ennukim/Moodmusic/Presentation.pdf

## Moodmusic

Anthony Lam and Sally Kim

### Design Concept

A music player that automatically chooses a music to play for the user depending on the user’s mood, defined by biometrics and environment.

### Key Parts

Sensors:

- Temperature (DS18B20)
- Motion (ADXL345)
- Light (Photoresistor)
- Heart Rate

Others:

- ADC (MCP3002)
- Audio Jack (Stereo Decoder)

### Circuits - Analog Sensors

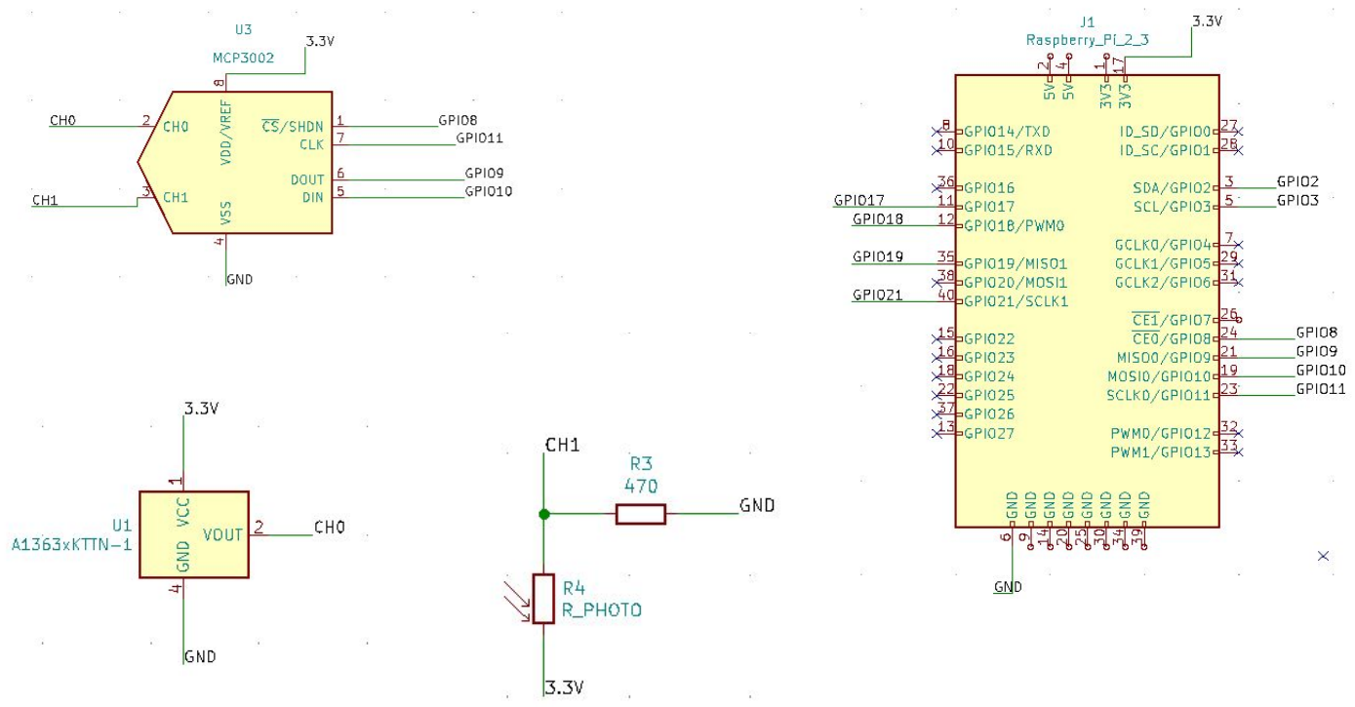
[picture p12: figure]

Ch0 - Heart rate
sensor

Ch1 - Photoresistor

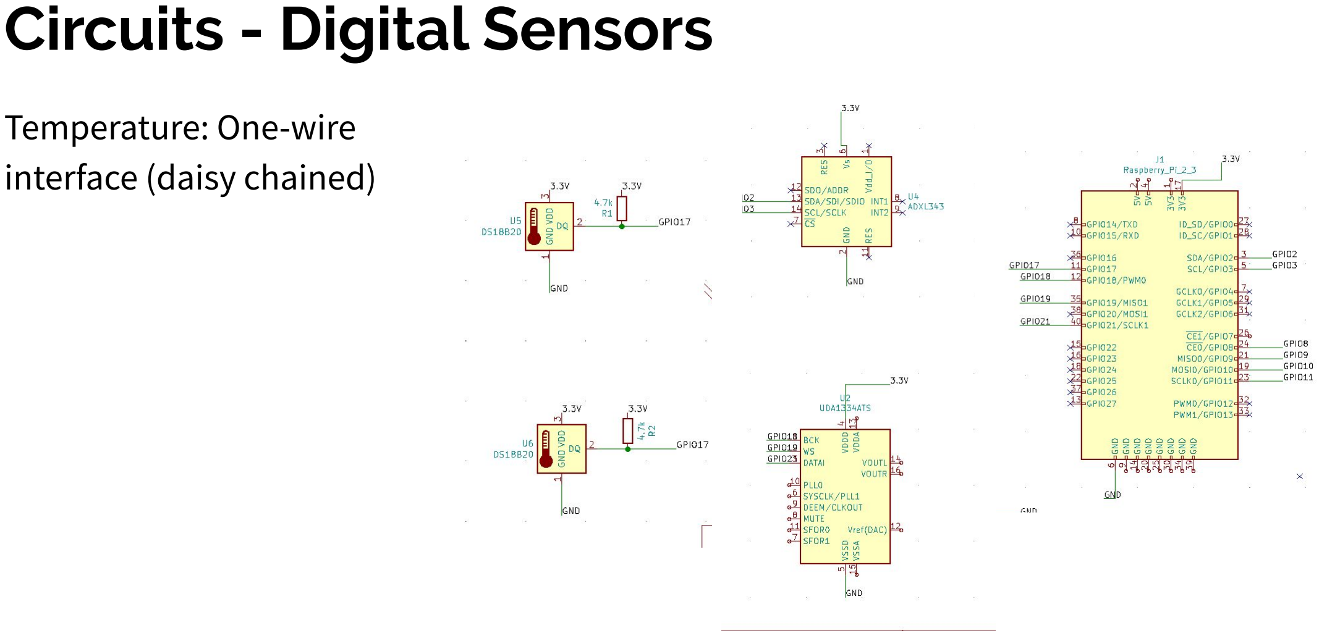
[picture p13: page 5]

### Circuits - Digital Sensors

Temperature: One-wire
interface (daisy chained)

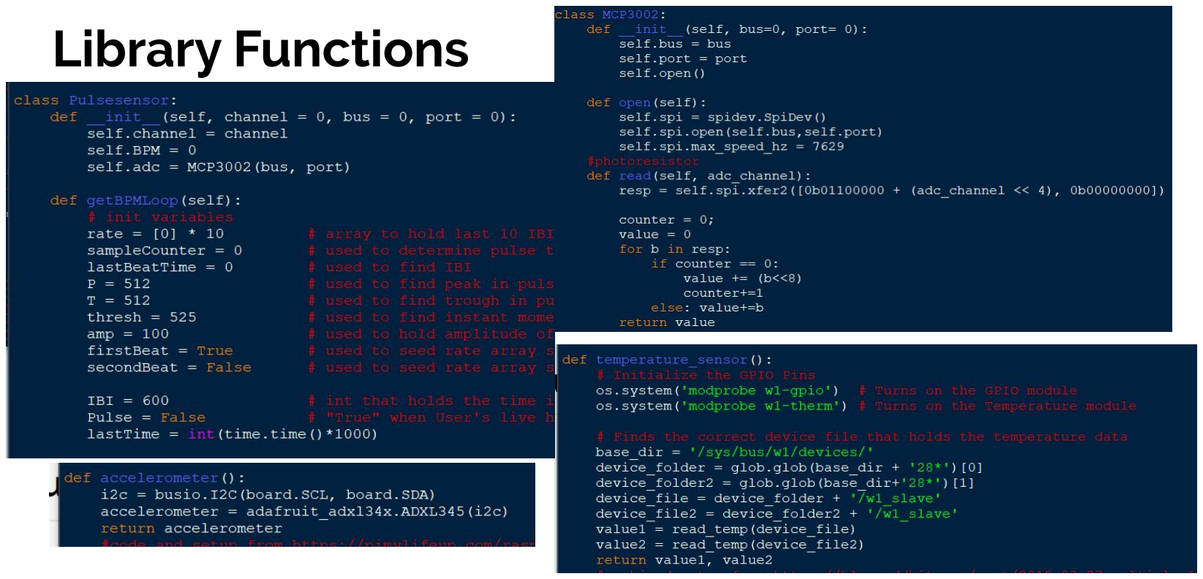
[picture p14: page 6]

### Library Functions

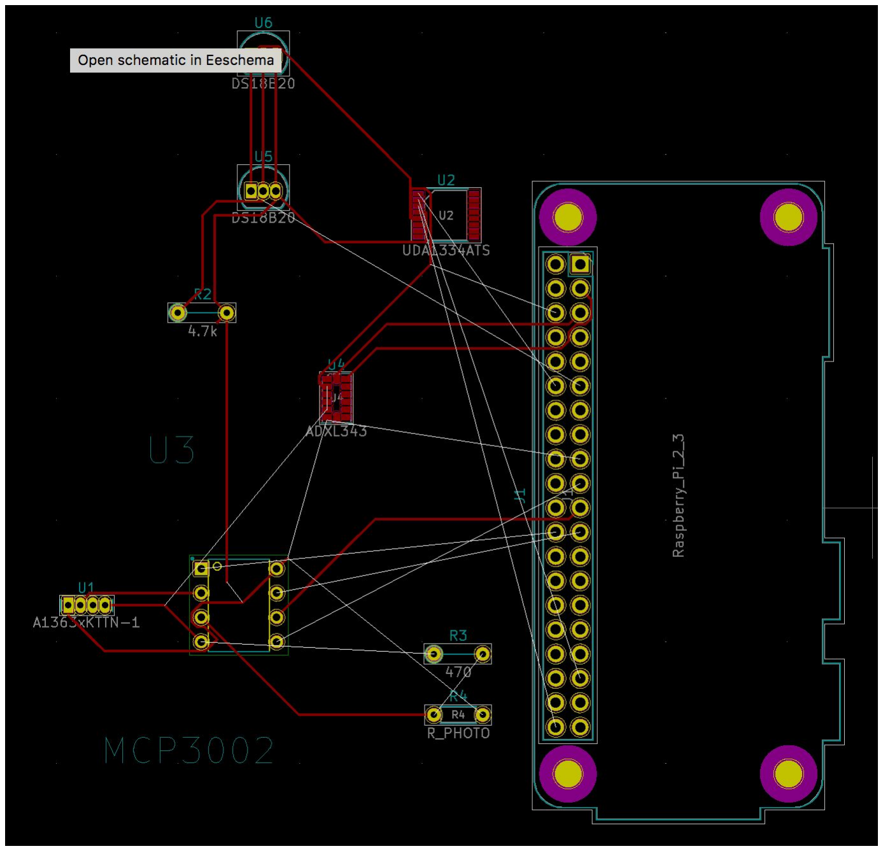
[picture p15: figure]

### PCB layout
