ennukim/Moodmusic/hardware_design/moodmusic_schematic.pdf

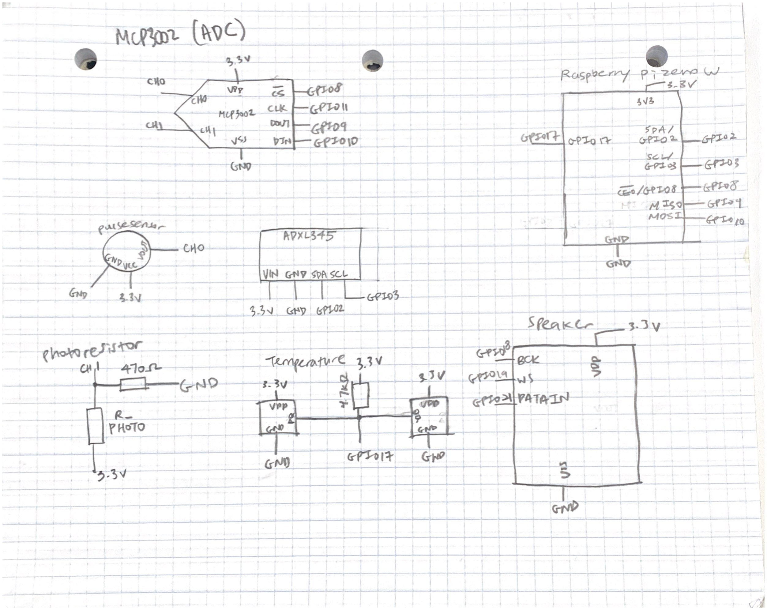
[picture p16: figure]
