ennukim/Moodmusic/mood_algorithm.png

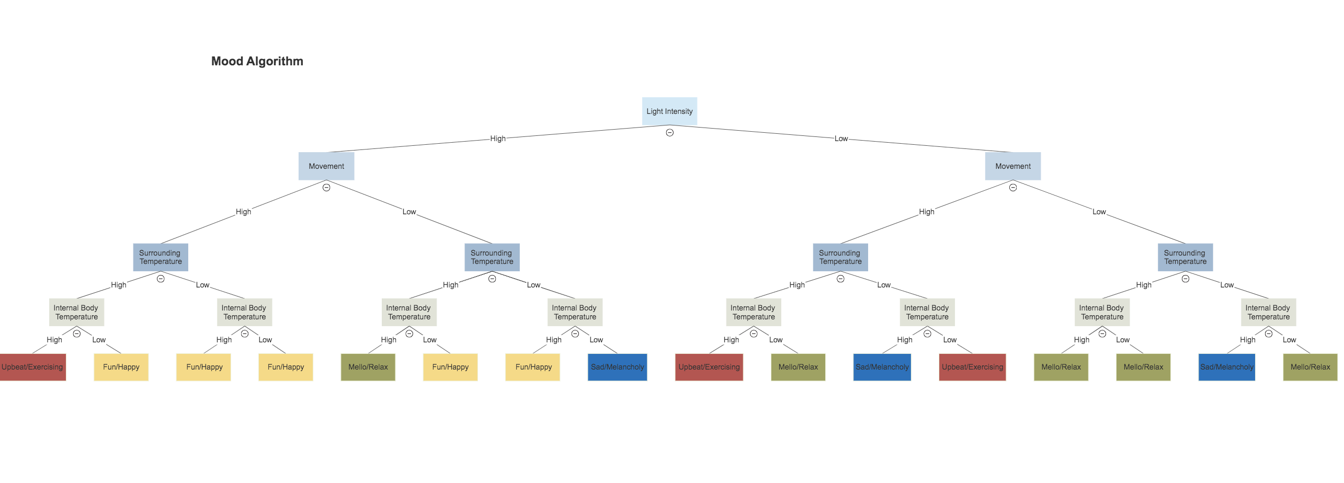
mood_algorithm.png
