ennukim/Moodmusic/UI/add_music.png

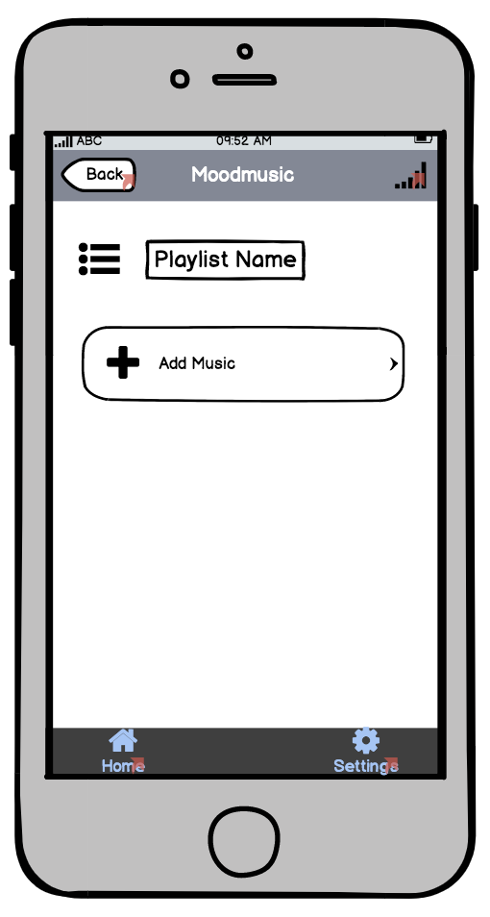
UI/add_music.png
