ennukim/Moodmusic/UI/home_screen.png

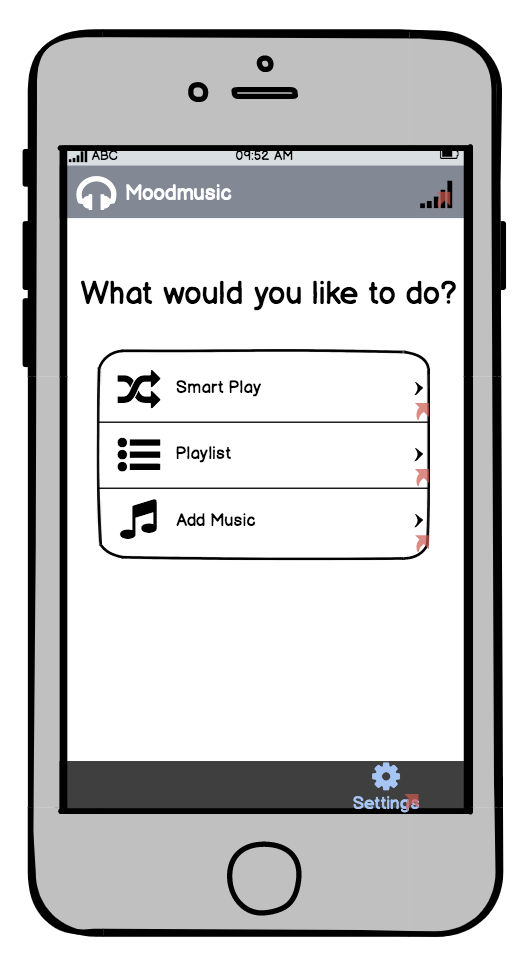
UI/home_screen.png
