ennukim/Moodmusic/UI/import_music.png

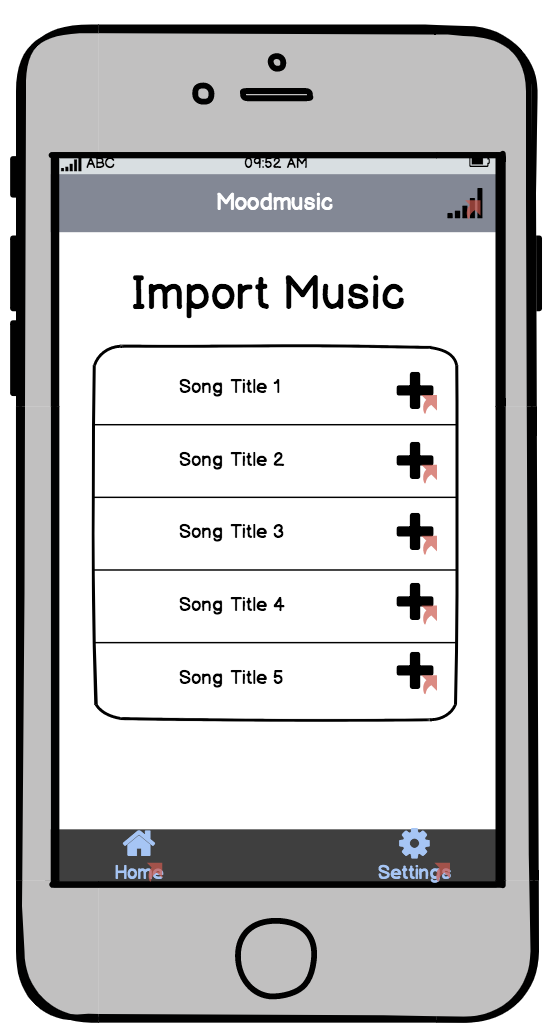
UI/import_music.png
