ennukim/Moodmusic/UI/label_mood.png

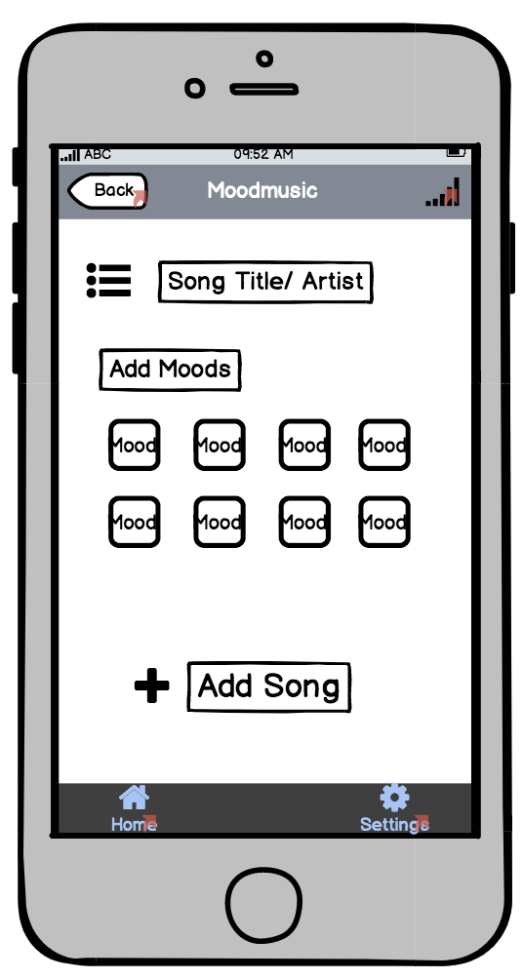
UI/label_mood.png
