ennukim/Moodmusic/UI/mood_config.png

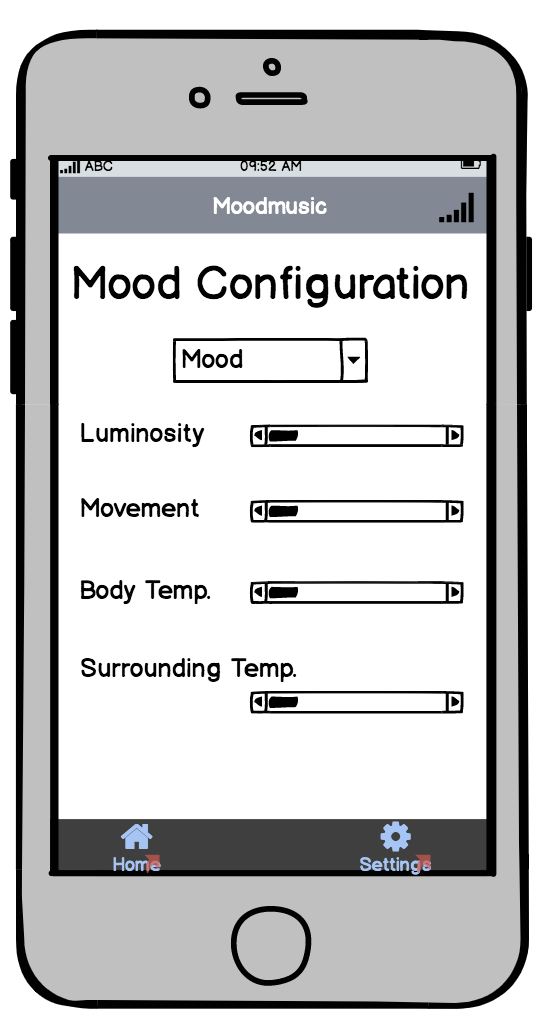
UI/mood_config.png
