ennukim/Moodmusic/UI/mood_description.png

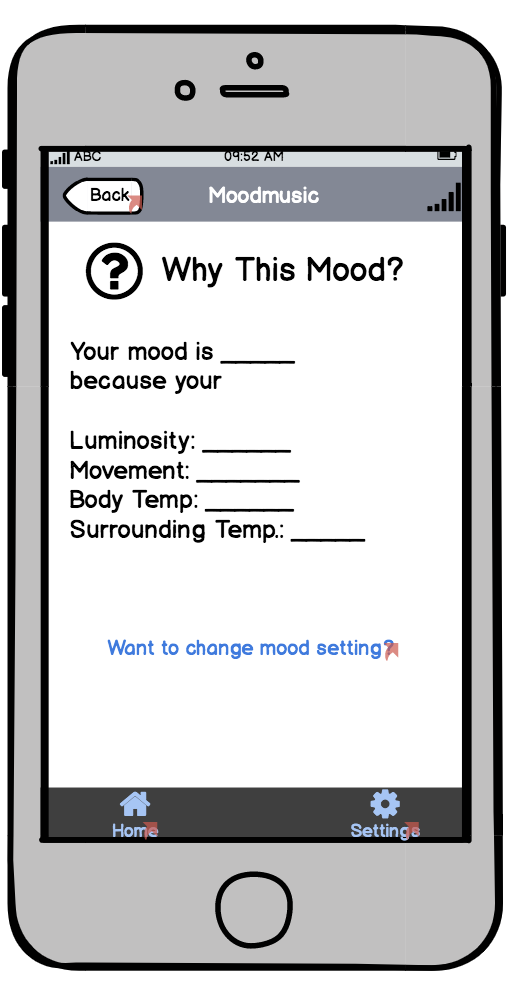
UI/mood_description.png
