ennukim/Moodmusic/UI/music_screen.png

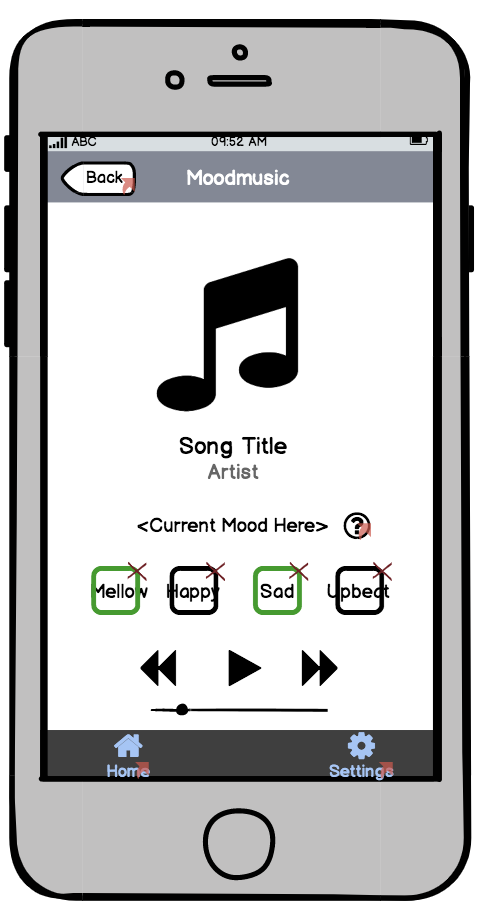
UI/music_screen.png
