ennukim/Moodmusic/UI/playlist.png

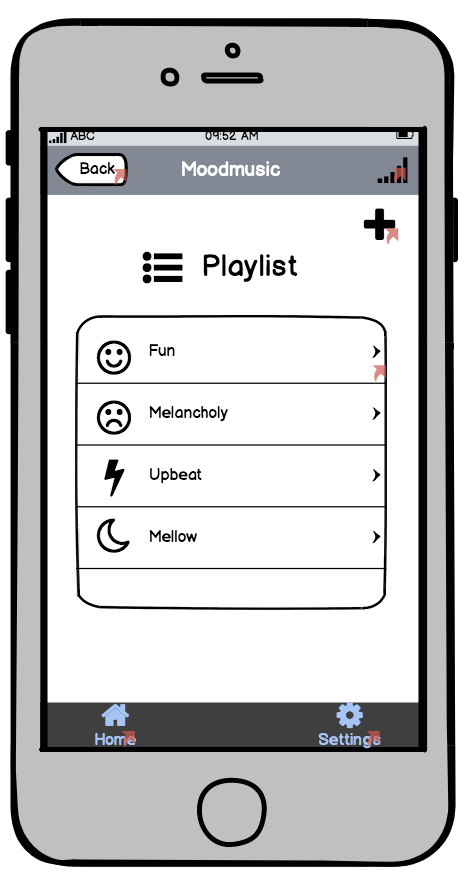
UI/playlist.png
