ennukim/Moodmusic/UI/playlist_fun.png

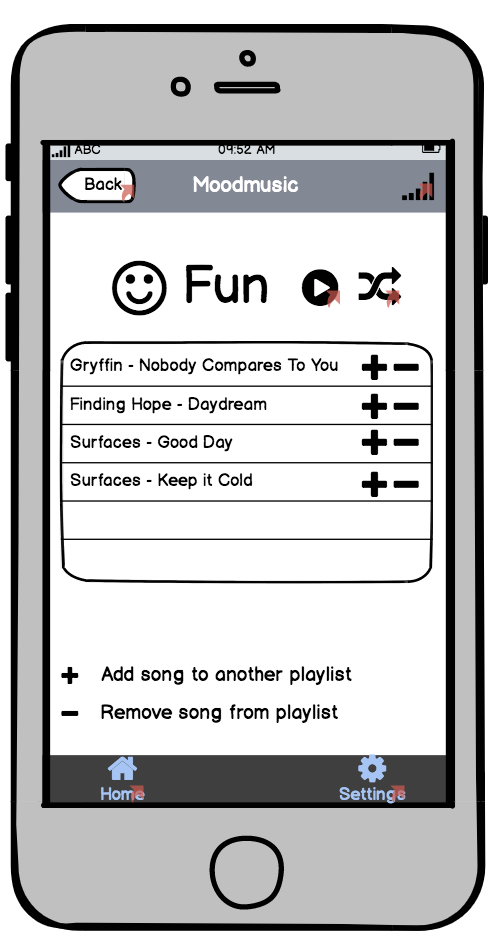
UI/playlist_fun.png
