ennukim/Moodmusic/UI/recollect.png

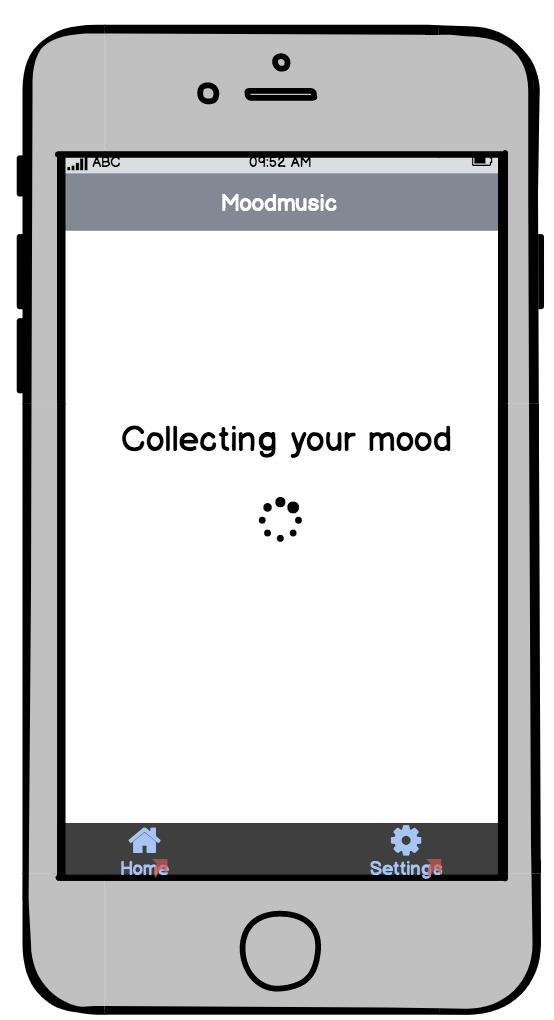
UI/recollect.png
