ennukim/Moodmusic/UI/settings.png

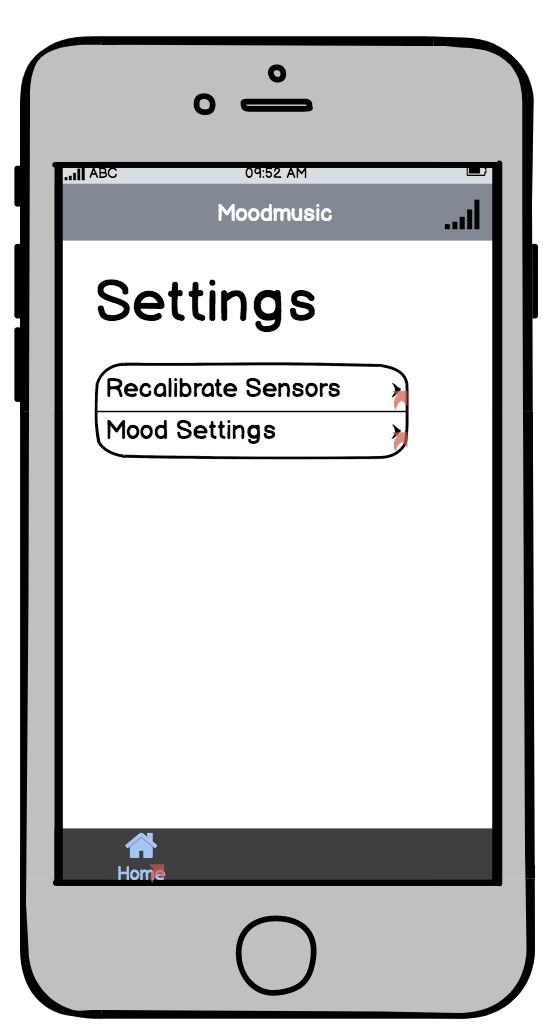
UI/settings.png
