ennukim/Moodmusic/hardware_design/Moodmusic_breadboard.pdf

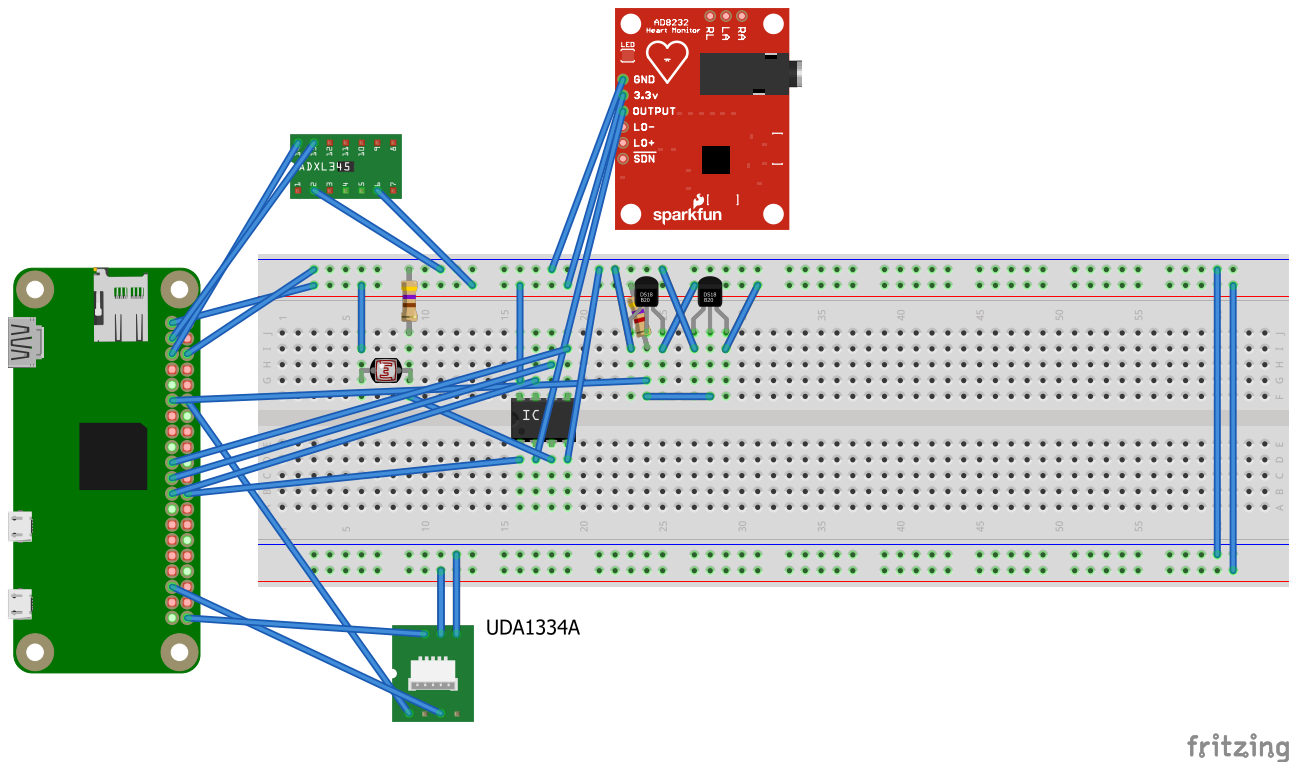
[picture p29: page 1]
