ennukim/Moodmusic/hardware_design/pcb-bottom.pdf

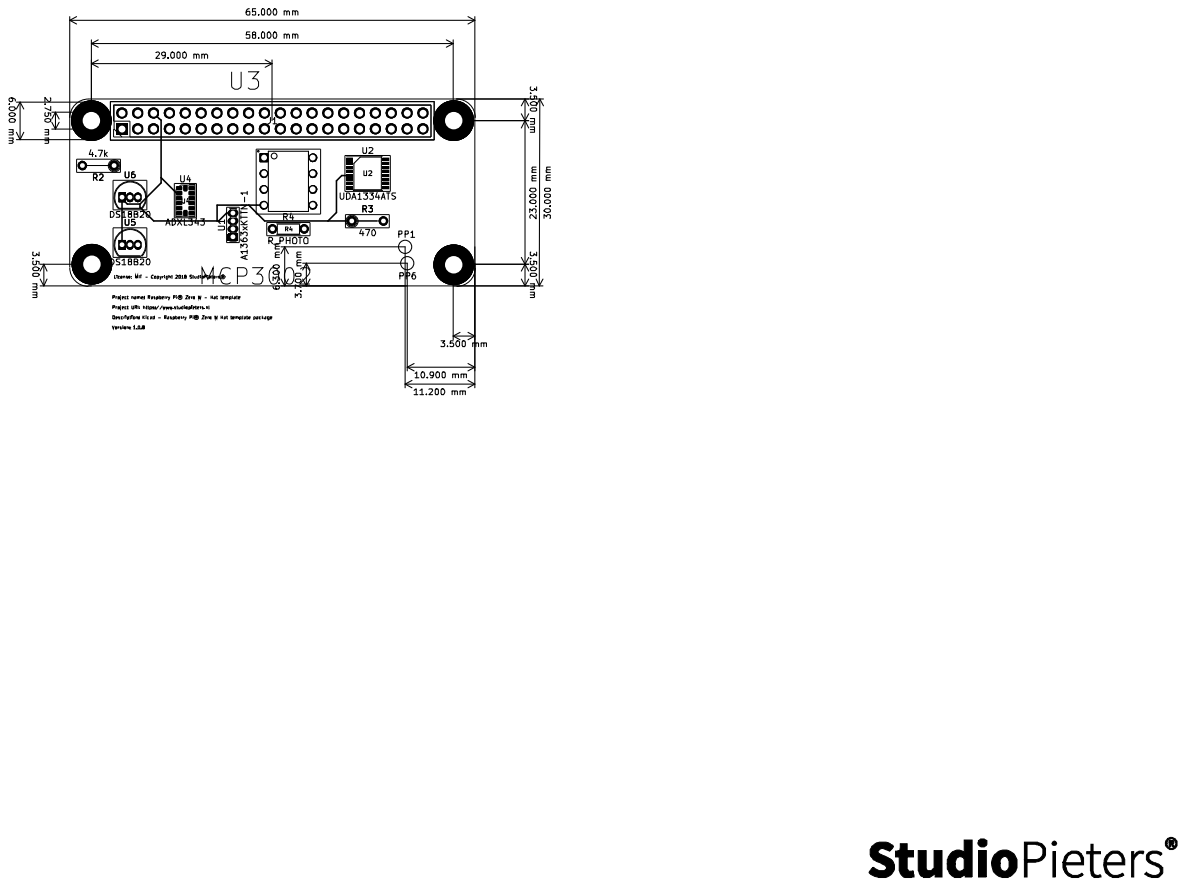
[picture p30: page 1]
