ennukim/Moodmusic/hardware_design/pcb-top.pdf

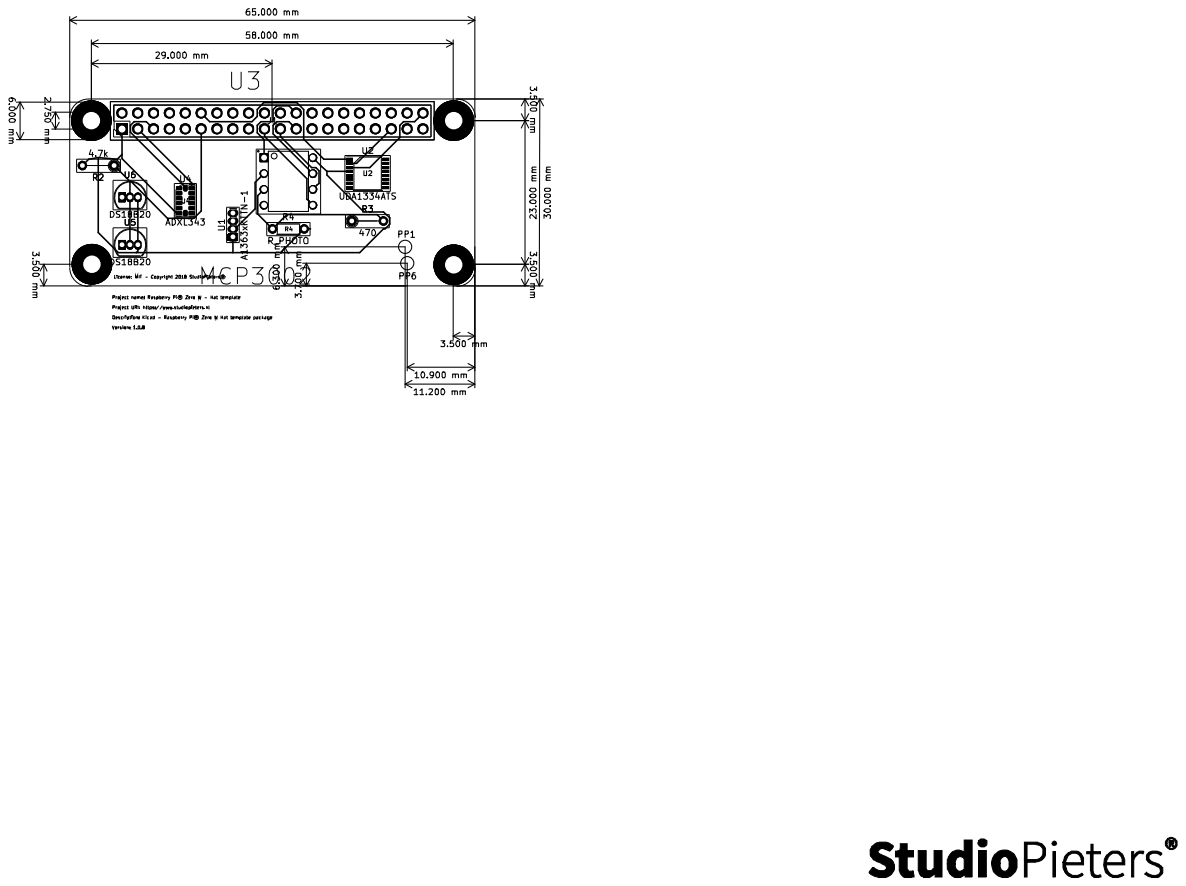
[picture p31: page 1]
