ennukim/Moodmusic/(list of files, drawings)

Other design files:
hardware_design/breadboard.fzz
