ennukim/Moodmusic/hardware_design/pcb-design.kicad_pcb

## KiCad design hardware_design/pcb-design.kicad_pcb (2020-10-31)

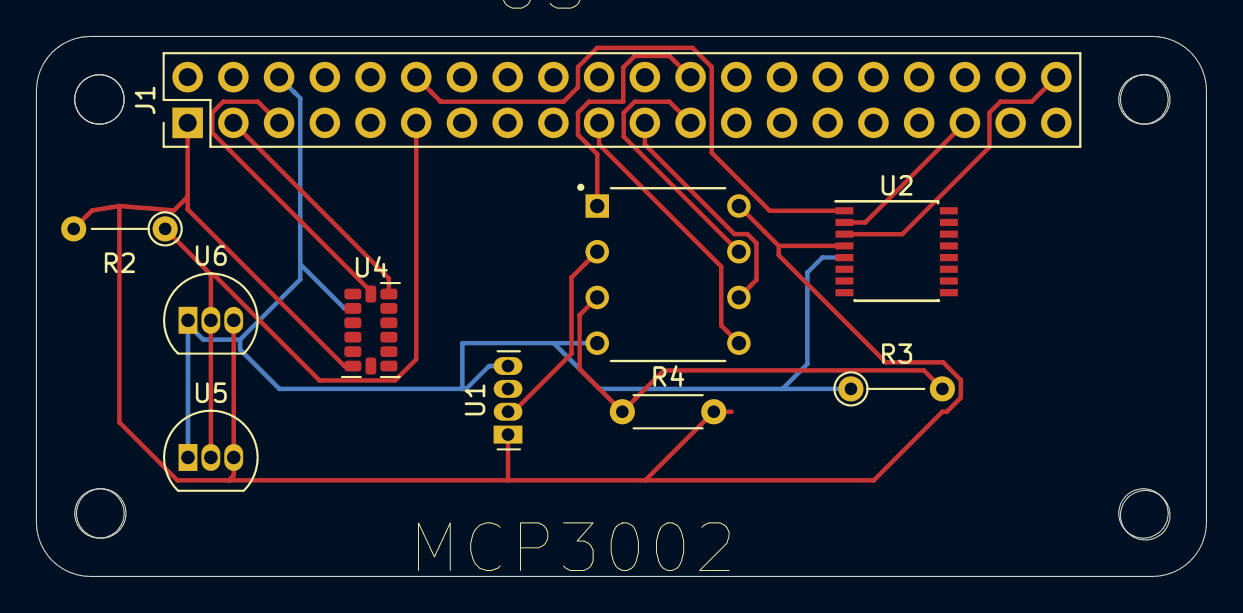
[picture p32: board pcb-design.kicad_pcb from above]

Board: 2 copper layers, 65.0 x 30.0 mm, 10 parts (0 on the bottom side), 14 nets.

Parts:
J1: Conn_02x20_Odd_Even; PinHeader_2x20_P2.54mm_Vertical
R2: 4.7k; R_Axial_DIN0204_L3.6mm_D1.6mm_P5.08mm_Vertical
R3: 470; R_Axial_DIN0204_L3.6mm_D1.6mm_P5.08mm_Vertical
R4: R_PHOTO; R_Axial_DIN0204_L3.6mm_D1.6mm_P5.08mm_Horizontal
U1: A1363xKTTN-1; Allegro_SIP-4
U2: UDA1334ATS; SSOP-16_4.4x5.2mm_P0.65mm
U3: MCP3002; DIP787W46P254L927H533Q8
U4: ADXL343; LGA-14_3x5mm_P0.8mm_LayoutBorder1x6y
U5, U6: DS18B20; TO-92_Inline

Connections:
/3.3V: J1.1, R2.2, R4.2, U1.1, U2.4, U3.8, U4.6, U5.3, U6.3
/CH0: U1.2, U3.2
/CH1: R3.2, R4.1, U3.3
/GND: J1.6, R3.1, U1.4, U2.5, U3.4, U4.2, U4.4, U4.5, U5.1, U6.1
/GPIO2: J1.3, U4.13
/GPIO3: J1.5, U4.14
/GPIO8: J1.24, U3.1
/GPIO9: J1.21, U3.6
/GPIO10: J1.19, U3.5
/GPIO11: J1.23, U3.7
/GPIO17: J1.11, R2.1, U5.2, U6.2
/GPIO18: J1.12, U2.1
/GPIO19: J1.35, U2.2
/GPIO21: J1.40, U2.3
