ennukim/Moodmusic/(notices)

Notices in the files:
hardware_design/pcb-design.kicad_pcb:
License: MIT - Copyright 2018 StudioPieters®
